jaymsteele/ECEN_403-4_Mesh_Walkie_Talkies/README.md

# ECEN_403-4_Mesh_Walkie_Talkies
ECEN capstone github repository for Mesh Walkie Talkies
