jaymsteele/ECEN_403-4_Mesh_Walkie_Talkies/404 Presentations/Status Update 1 - Team 36.pptx

## Team 36: Mesh Walkie Talkies Bi-Weekly Update 1 Jaiah Steele, Cole Cieslewicz, Junsu Yeo Sponsor: Giuseppe Rizzi TA: Niloofar Borzooei


Notes: Michelle

## Project Summary

- Conventional Walkie-Talkies:
  - Require close, limited communication
    - Not as effective for large area coordination
  - No network advantage
- Our Solution:
  - Mesh network to extend range and communication reliability


Notes: Kyle

## Project/Subsystem Overview

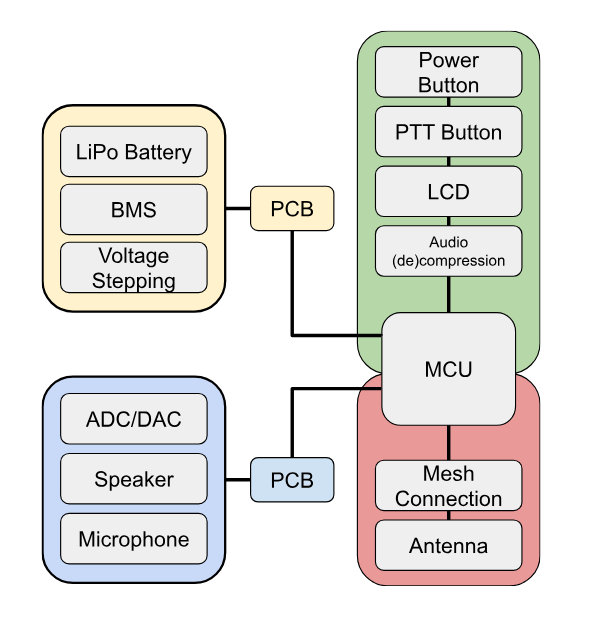
[picture p37: figure]

Notes: Eric

## Major Project Changes for 404

- Team Changes:
  - Had a member drop during 403 (whose responsibilities were mainly audio/MCU hardware)
  - Members tasks were split amongst Junsu/Jaiah
- Project Changes:
  - Launchpads vs custom PCB’s
  - Talk to sponsor about utilizing launchpads in final projects
  - Migrate from UART comm. to audio interface

Notes: Eric

## Project Timeline

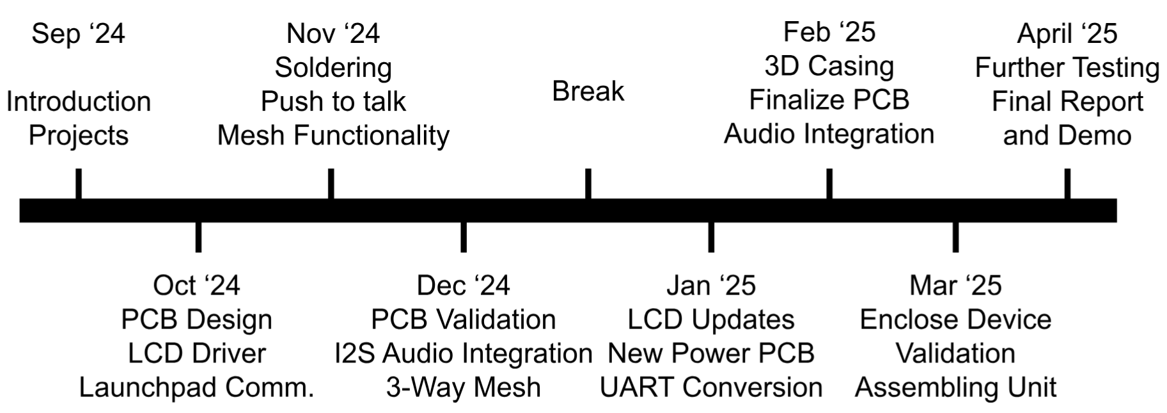
[picture p38: figure]

Notes: Eric

## Push-To-Talk/Audio Functionality Jaiah

Accomplishments since 403 3 hrs of effort | Ongoing progress/problems and plans until the next presentation
Final demo - Push-To-Talk functionality/I2s audio echo still functional. Ordered remaining parts needed: Antennas, microphones, speakers, LCD’s for 3 working sets of walkies. | Have LCD update across launchpads/verify mesh transmission. Investigate audio transmission measurements i.e sample rate (8Khz min), bits per sample (8-bit min), and bitrate of transmission.

## Slide 7

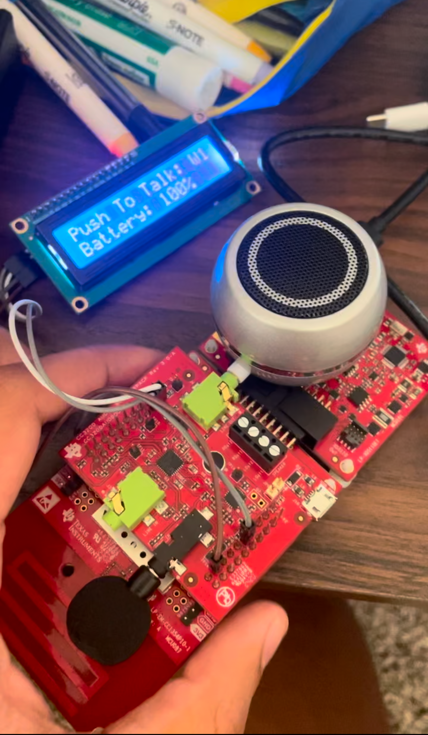
[picture p39: figure]
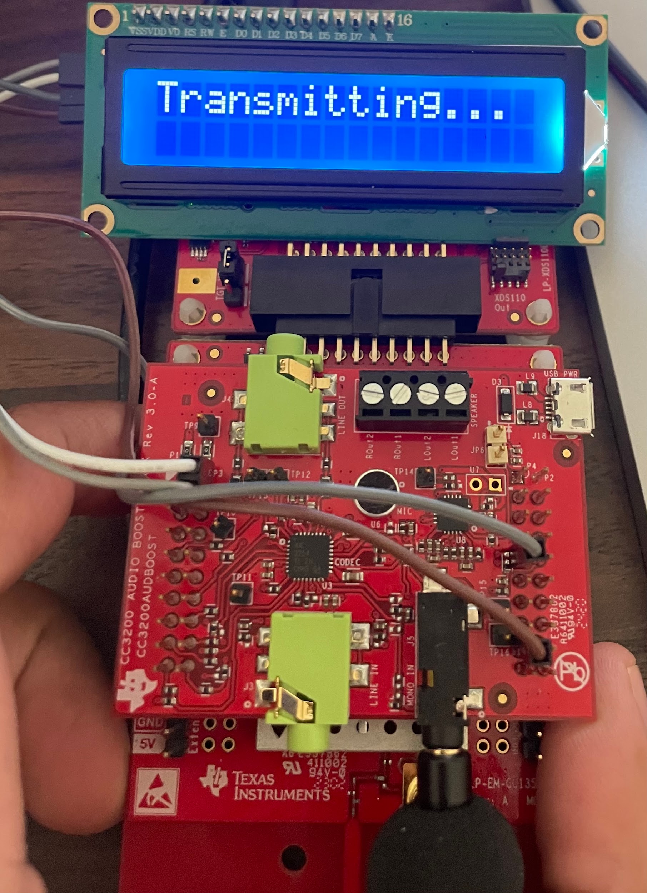
[picture p40: figure]
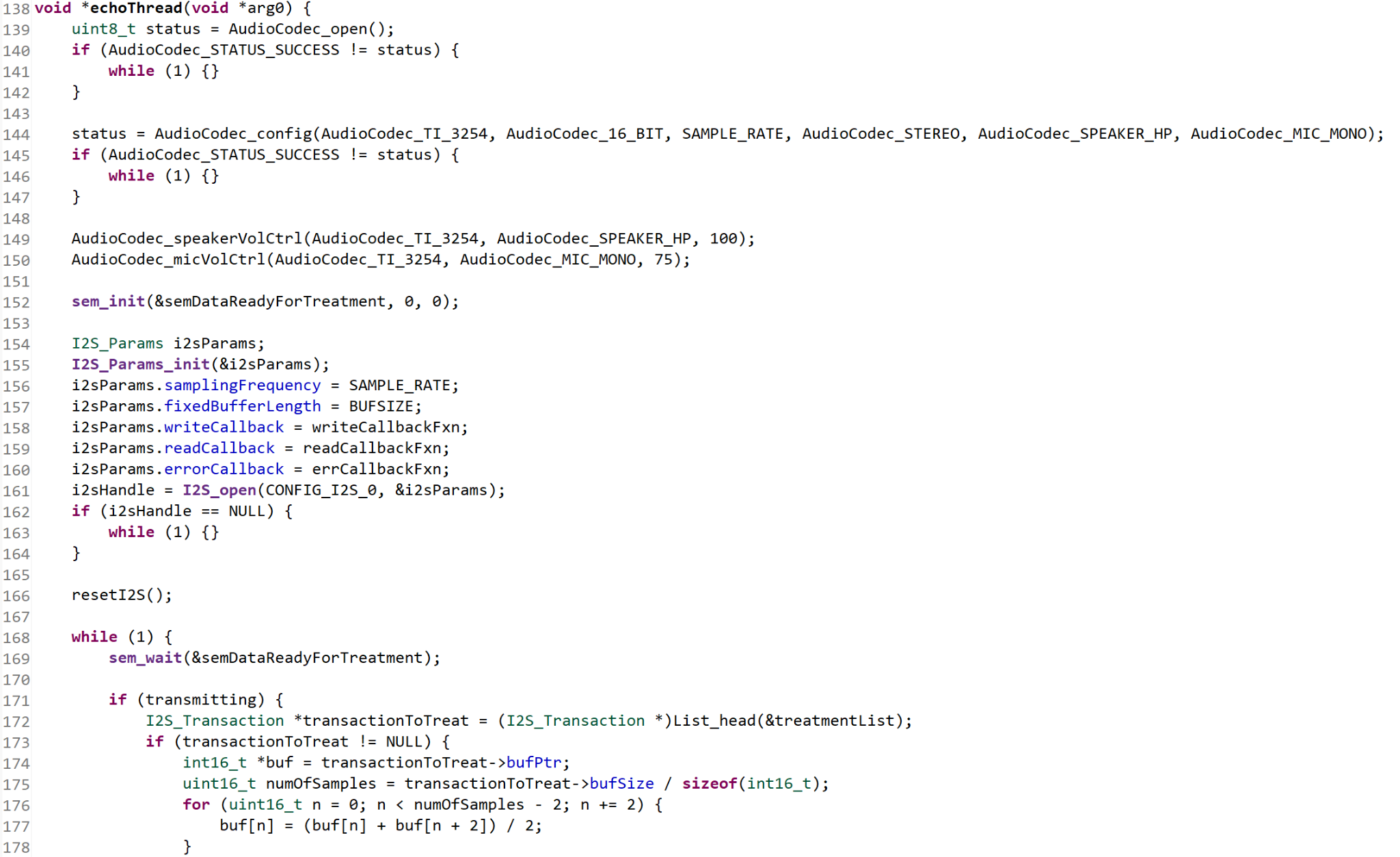
[picture p41: figure]

## Mesh Connection Subsystem Cole Cieslewicz

Accomplishments since 403 3 hrs of effort | Ongoing progress/problems and plans until the next presentation
I’ve made sure software is back up and running as expected (as I left it) from 403 demo. | I am going to identify how to migrate from UART text transmission to audio transmission with help of our AudioBoost add-ons and Jaiah’s sub-system.

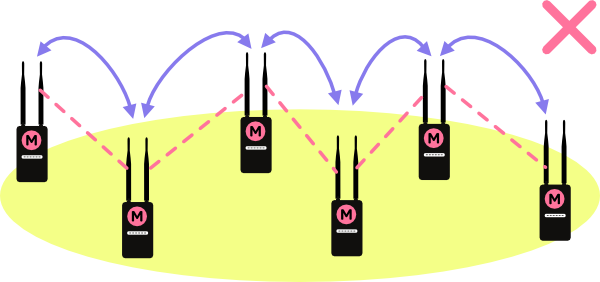
[picture p42: figure]
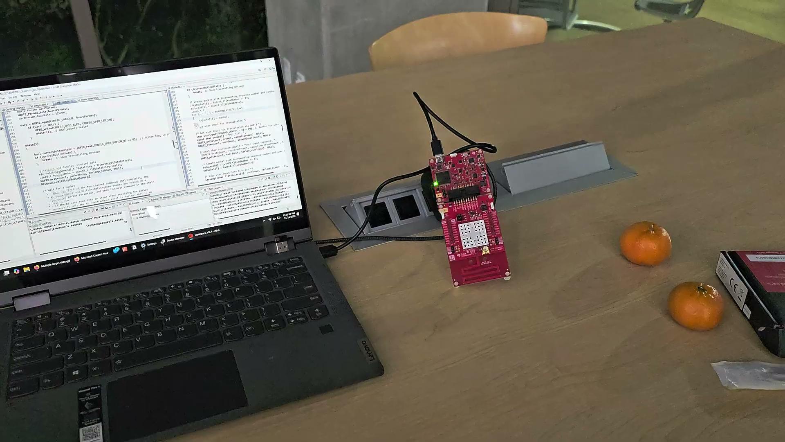
[picture p43: figure]

## Power Subsystem Junsu

Accomplishments since 403 6 hrs of effort | Ongoing progress/problems and plans until the next presentation
Finished PCB design for new converters. Battery charging is still working from last semester. | Finish assembly and validation of new PCB.

## Power System Junsu Yeo

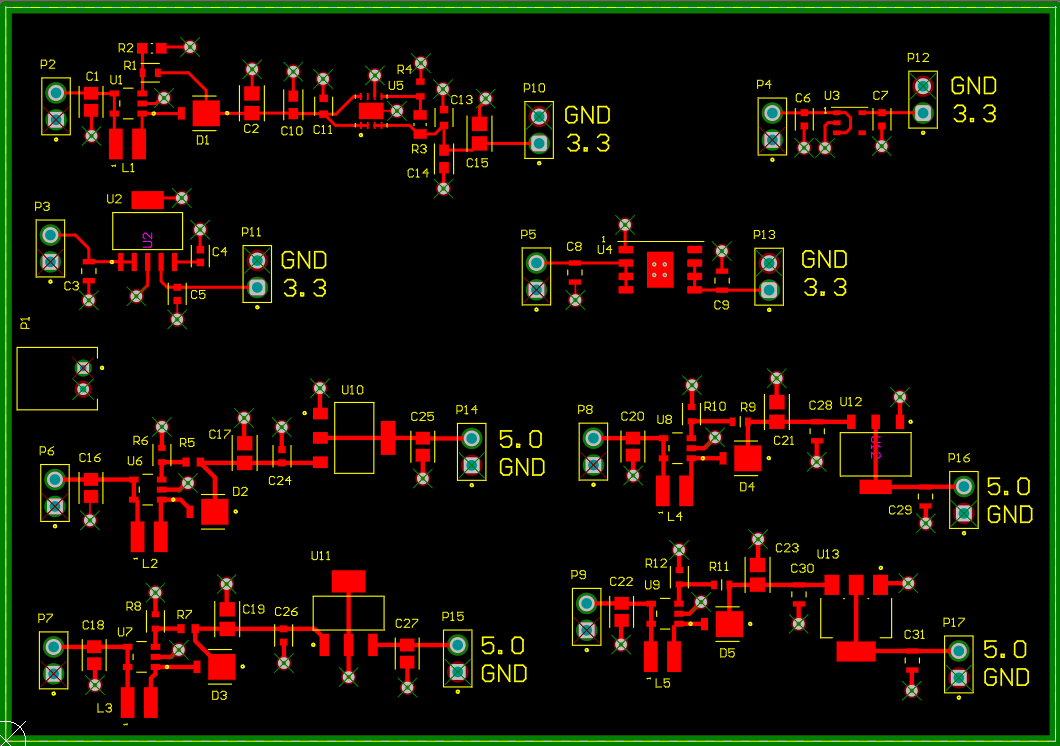
[picture p44: figure]

## Parts Ordering Status

New Power PCB | Ordered (Expected within this week)
All components for new PCB | Ordered (Expected within this week)
Speakers | Delivered
LCD’s | Delivered
Microphones | Delivered
915 MHz Radio Antennas | Delivered
TI 3200 AUDBOOST Audio Codec | Requesting from sponsor

Notes: Michelle

## Execution Plan

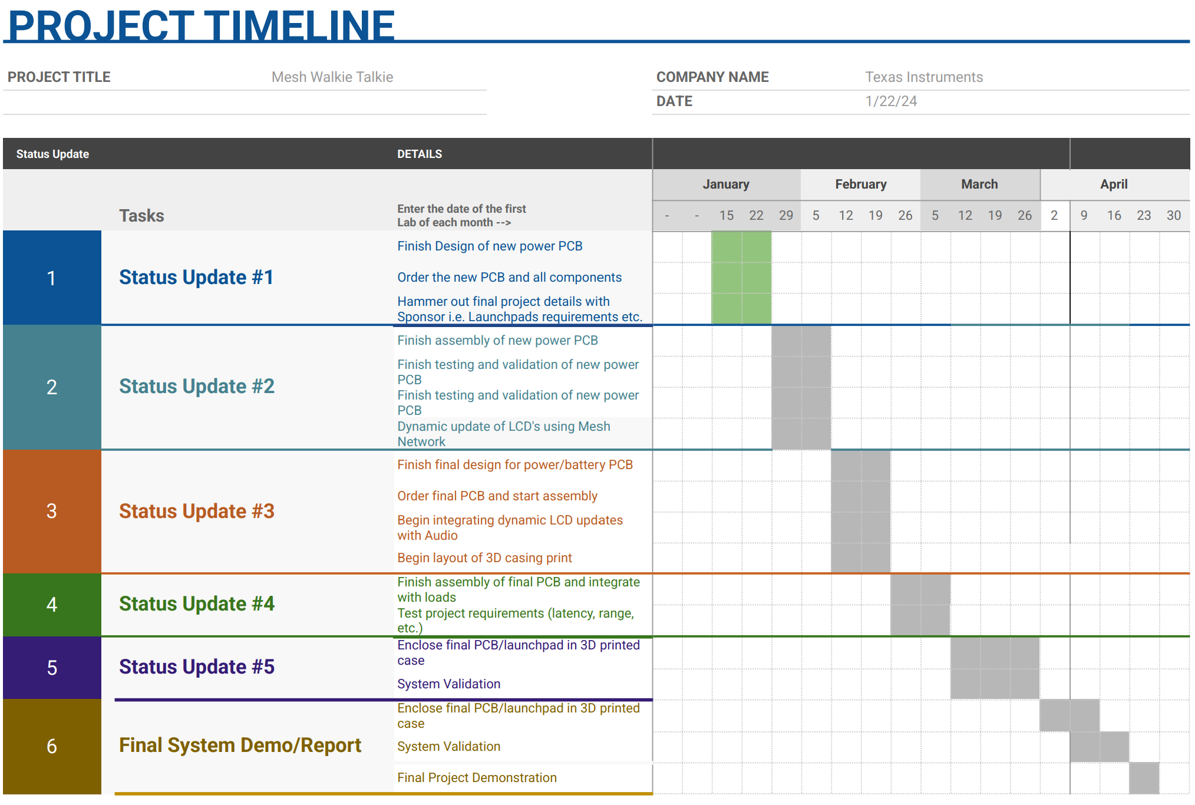
[picture p45: figure]
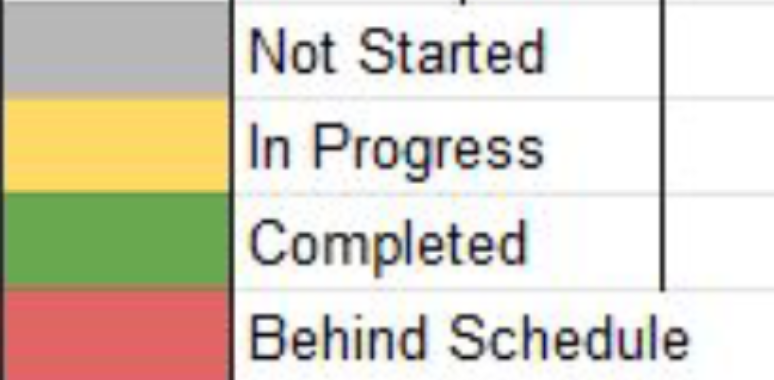
[picture p46: figure]

Notes: Michelle

## Validation Table

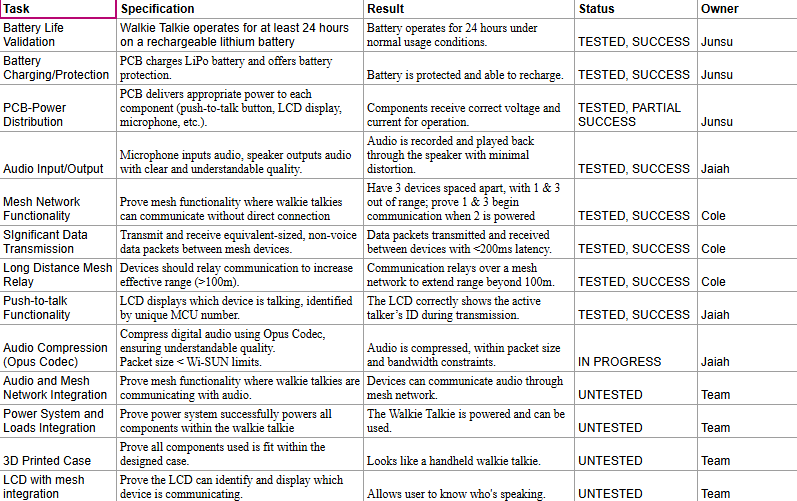
[picture p47: figure]

## Slide 14

Thank you!
