jaymsteele/ECEN_403-4_Mesh_Walkie_Talkies/3D_Print_Case/COMPACT_TOP.stl

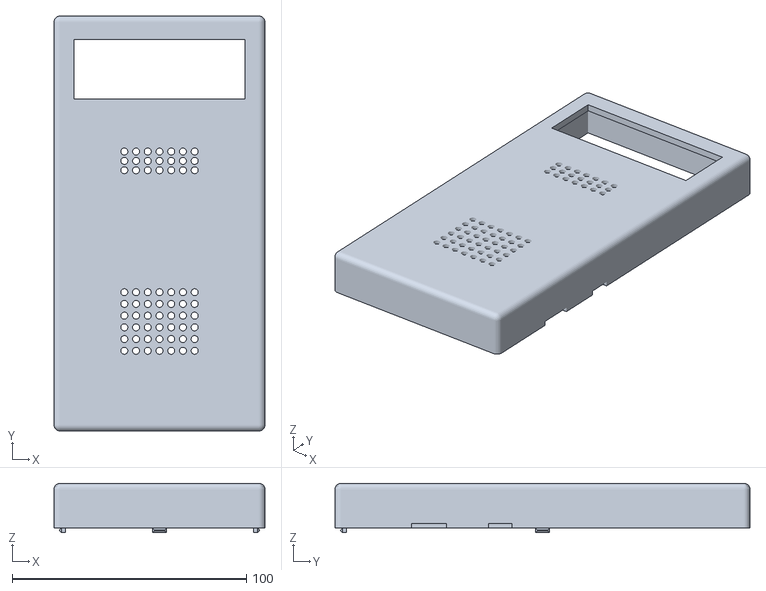
[picture p92: CAD file, 2025-05-02]
3D_Print_Case/COMPACT_TOP.stl
90.0 x 177.0 x 21.0
