jaymsteele/ECEN_403-4_Mesh_Walkie_Talkies/Validation Table (1).xlsx

Task | Specification | Result | Status | Owner
Battery Life Validation | Walkie Talkie operates for at least 24 hours on a rechargeable lithium battery | Battery operates for 24 hours under normal usage conditions. | TESTED, SUCCESS | Junsu
Battery Charging/Protection | PCB charges LiPo battery and offers battery protection. | Battery is protected and able to recharge. | TESTED, SUCCESS | Junsu
PCB-Power Distribution | PCB delivers appropriate power to each component (push-to-talk button, LCD display, microphone, etc.). | Components receive correct voltage and current for operation. | TESTED, SUCCESS | Junsu
Audio Input/Output | Microphone inputs audio, speaker outputs audio with clear and understandable quality. | Audio is recorded and played back through the speaker with minimal distortion. | TESTED, SUCCESS | Jaiah
Mesh Network Functionality | Prove mesh functionality where walkie talkies can communicate without direct connection | 2 devices in range with each other can communicate without errors | TESTED, SUCCESS | Cole
|| | || | Have 3 devices spaced apart, with 1 & 3 out of range; prove 1 & 3 begin communication when 2 is powered | TESTED, SUCCESS | Cole
SIgnificant Data Transmission | Transmit and receive equivalent-sized, non-voice data packets between mesh devices. | 8kb/s transmitted between devices, proven in TI's RF Studio | TESTED, SUCCESS | Cole
|| | || | Data packets transmitted and received between devices with <200ms latency, proven with audio samples | TESTED, SUCCESS | Cole
Long Distance Mesh Relay | Devices should relay communication to increase effective range (>100m). | Communication relays over a mesh network to extend range beyond 100m. | TESTED, SUCCESS | Cole
Push-to-talk Functionality | LCD displays which device is talking, identified by unique MCU number. | The device displays its own ID | TESTED, SUCCESS | Jaiah
|| | || | The LCD correctly shows the active talker’s ID during transmission. | TESTED, SUCCESS | Jaiah
LCD with mesh integration | Prove the LCD can identify and display which device is communicating. | Allows user to know who's speaking. | TESTED, SUCCESS | Jaiah
Power System and Loads Integration | Prove power system successfully powers all components within the walkie talkie | The walkie talkie powers on | TESTED, SUCCESS | Junsu
|| | || | The walkie talkie functions at all major components (speaker, microphone, MCU, buttons, antenna, LCD) | TESTED, SUCCESS | Junsu
Audio Packetization | Ensure audio is able to be split up into transmittable chunks that multiple walkie talkies can receive and send | Audio is able to be compressed into packets, proven by data display in TI's RF Studio | TESTED, SUCCESS | Cole
|| | || | Alternate device receives audio packet and is able to send it back out. | TESTED, SUCCESS | Cole
Audio Compression (Codec) | Compress digital audio using Opus Codec, ensuring understandable quality. Packet size < Wi-SUN limits. | Audio is compressed, within packet size and bandwidth constraints. | IN PROGRESS | Jaiah/Cole
Audio and Mesh Network Integration | Prove mesh functionality where walkie talkies are communicating with audio. | Devices can communicate audio through mesh network. | TESTED, SUCCESS | Team
3D Printed Case | Prove all components used is fit within the designed case. | Looks like a handheld walkie talkie. | TESTED, SUCCESS | Junsu
