jaymsteele/ECEN_403-4_Mesh_Walkie_Talkies/(list of files, drawings)

Other design files:
PCB/ECEN404_FinalPCB.PrjPcb
PCB/FINAL_PCB.PcbLib
PCB/FINAL_PCB_SCHEMATICLIBRARY.SchLib
PCB/FINAL_Walkie_Talkie_POWER_PCB.PcbDoc
PCB/FINAL_Walkie_Talkie_POWER_Schematic.SchDoc
