jaymsteele/ECEN_403-4_Mesh_Walkie_Talkies/(commit log)

2025-02-26 Update tx.c
    fixed LCD flashing and removed unnecessary sleep times
    [tx.c]
2025-03-06 Update tx.c no rf stall
    [tx.c]
